moanan/1_dof_motion_simulator/images/motion_simulator_actuated.png

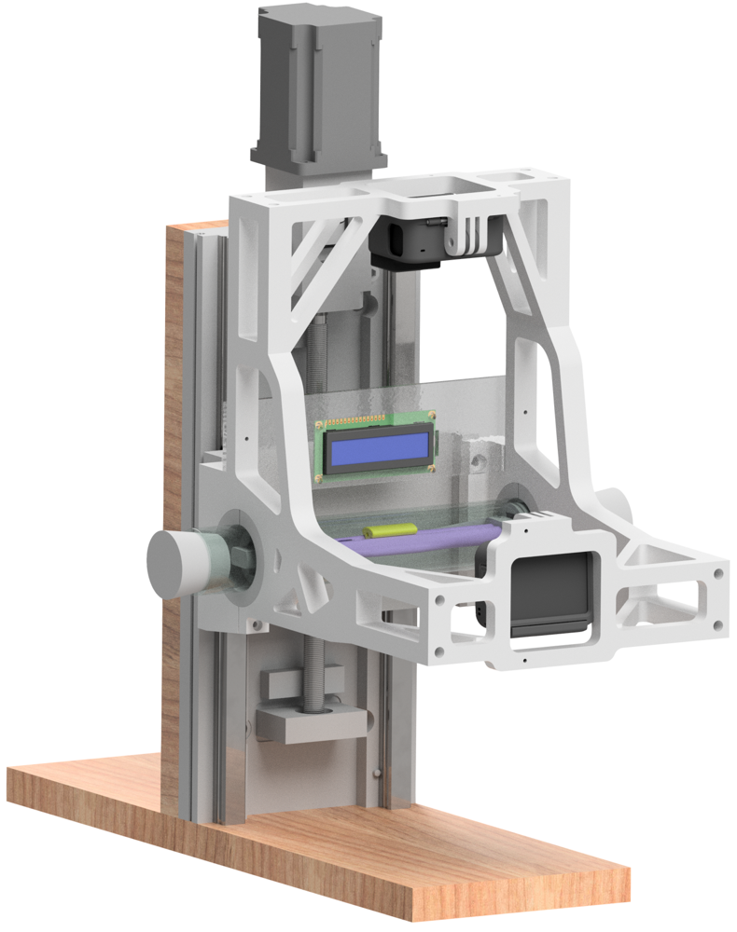
images/motion_simulator_actuated.png
