moanan/1_dof_motion_simulator/images/motion_simulator_manual.png

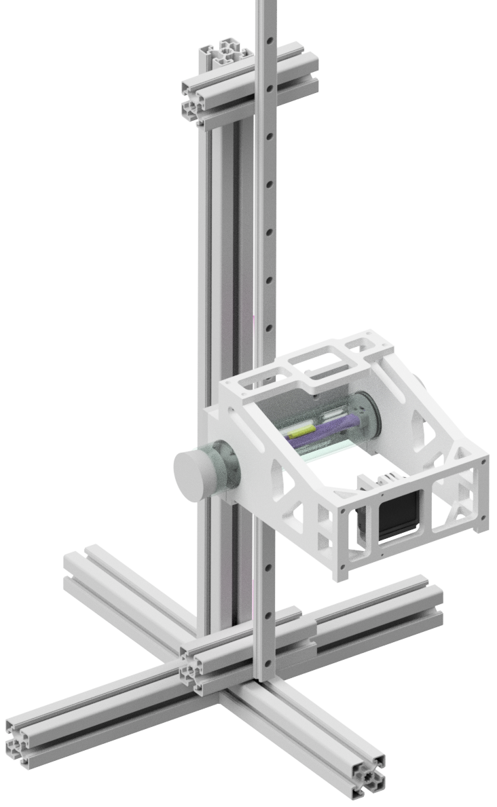
images/motion_simulator_manual.png
